TheRorange/-Comau_Smart5_NJ165/README.md

# Comau_Smart5_NJ165
This repository contains almost all files for analysis, simulation, design, programming, 3D printing, and assemblage of the Comau Smart5 NJ165 robot with a scale of 1:15 of the main size.
