TheRorange/-Comau_Smart5_NJ165/Report Eng.pdf

### Simulation and control of three degrees of freedom robot based on Comau smart5 NJ165

Sina Hasani Sadi

Department of electrical
engineering

sina_hs@aut.ac.ir

Romina Alishah

Department of electrical
engineering

elromina79@gmail.com

Shakila Kazempour
Dizaji

Department of electrical
engineering

shakila_kp@aut.ac.ir

Mahsa Beglari

Department of electrical
engineering

mahsabeglari@aut.ac.ir

Parisa Fakhre Tabatabaie

Department of electrical
engineering

Par_fr@aut.ac.ir

Mohamad Mahdi Malverdi

Department of electrical
engineering

mahdi.ma78@aut.ac.ir

Mahdi Keshtani Mehrzad

Department of electrical
engineering

m.mehrzad@aut.ac.ir

Abstract__ In this article, a three-degree-of-freedom robot is designed by SOLIDWORKS, then we
attempted to implement the robot practically, and finally, controlled the robot using Arduino and MATLAB.

INTRODUCTION

Nowadays, industrial robots play an important role in performing complex operations at high speeds. This category of robots must have the ability to perform precise and sensitive operations continuously and repeatedly. However, robot

manufacturers | make | controllers
available to users so that they can
improve | their | capabilities | and
computing power. On the other hand, the scientific community requires conducting numerous researches and improvements on systems in a short period of time. In this project, work will be done on the Comau Smart5 NJ165 robot.

To simplify the project in our practical work, we modeled a three-degree-of-freedom robot based on the first three degrees of freedom of Comau Smart5 NJ165 on a smaller scale.

Considering that the last three joints of their axes pass through the same point, it does not affect the movement of the end effector and only determines its orientation.

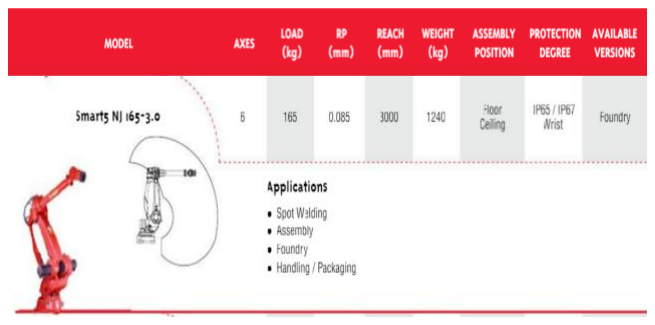
[picture p1: figure]
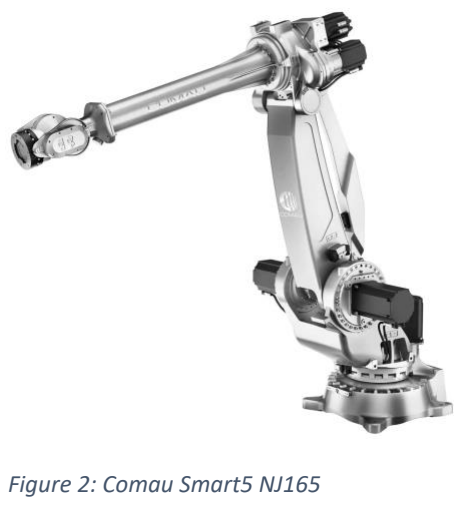
[picture p2: figure]
Figure 2: Comau Smart5 NJ165

Ⅰ. Robot design

The first step to implement the robot is to design it in software such as SOLIDWORKS, then links of the robot can be printed with help of 3D printing technology.

The main issue here was to keep the weight of the robot as low as possible but at the same time, it had to be large enough for motors to be placed on it. By using knowledge of the mechanics of materials we tried to lower the weight by omitting extra parts of the robot and making links hollow. Also, added some beams to the weak points to increase the strength of those points against loads and stresses acting on them.

Figure 1: Comau Smart5 basic info

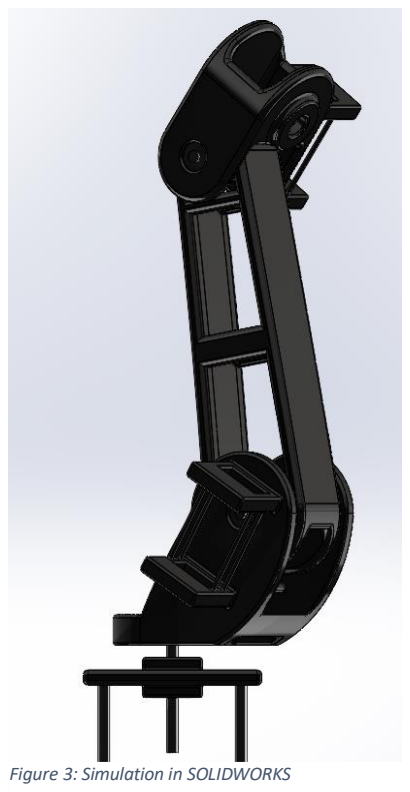
[picture p3: figure]
Figure 3: Simulation in SOLIDWORKS

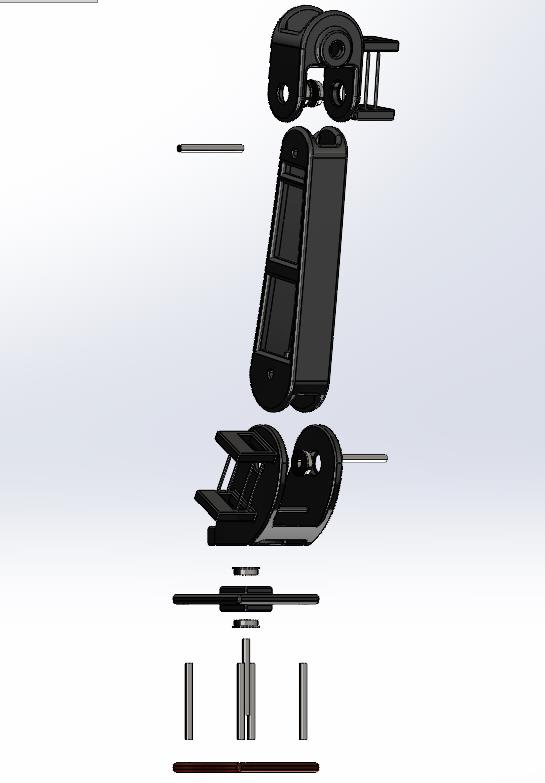
[picture p4: figure]
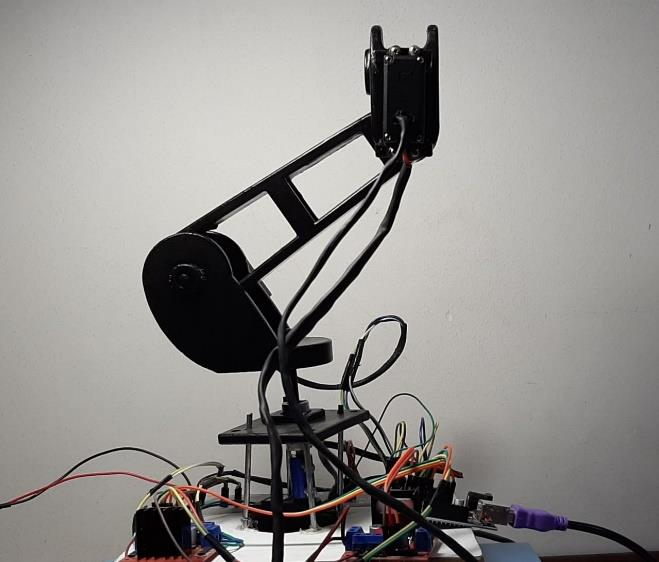
[picture p5: figure]

Figure 5: Assembled robot

Ⅱ. Forward Kinematics

To control the arm, we needed forward and inverse kinematics of the robot. Results are shown below:

T0

3
= [

σ1
σ2cos(θ3

) − σ3sin (θ3)

σ3 sin(θ3

) − σ2 cos(θ3

)
σ1

0 −0.146875(sin(θ2

) cos(θ1

) + sin(θ1

) cos(θ2

)) − 0.03125(σ3 cos(θ3

) + σ2 sin(θ3

))
0 −0.146875(cos(θ2

) cos(θ1

) + sin(θ1

) sin(θ2

)) − 0.03125(σ2 cos(θ3

) + σ3 sin(θ3

))
0 | 0 | 1 | 0.015
0 | 0 | 0 | 1

]

σ1 = −σ3sin(θ3

) − σ2 cos(θ3

)

σ2 = cos(θ1

) cos(θ2

) − sin(θ1

) sin(θ2

)

σ3 = cos(θ1

) sin(θ2

) − sin(θ1

) cos(θ2

)

End Effector Position:

P =
[

−0.146875(sin(θ2

) cos(θ1

) + sin(θ1

) cos(θ2

)) − 0.03125(σ3 cos(θ3

) + σ2 sin(θ3

))
−0.146875(cos(θ2

) cos(θ1

) + sin(θ1

) sin(θ2

)) − 0.03125(σ2 cos(θ3

) + σ3 sin(θ3

))
0.015

]

Transform matrix is obtained based on Classical Denavit Hartenberg method.

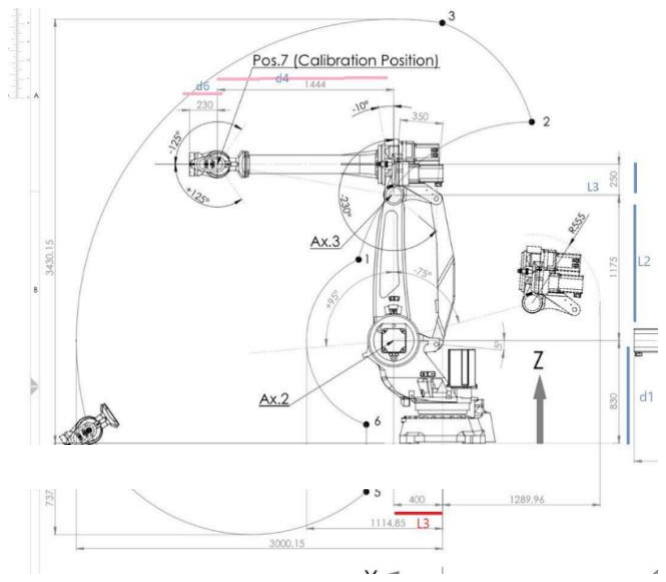
[picture p6: figure]

Ⅲ. Inverse Kinematics

Pee = [

x
y
z

]

θ1 = atan2(x, y)

Figure 4: Robot links

Figure 6

θ3 = cos⁻¹ (
x

2 + y

2 + (z − 0.015)

2 − 0.0225488281
0.0091796875 | )

θ2 =
tan⁻¹

(
0.0045898438sin(θ3

)+0.0004882813 sin(2θ3

)±(z−0.015)√x
2+y²

x

2+y²+0.0215722656+0.0009765625cos²(θ3 )+0.0091796875cos (θ3)

)

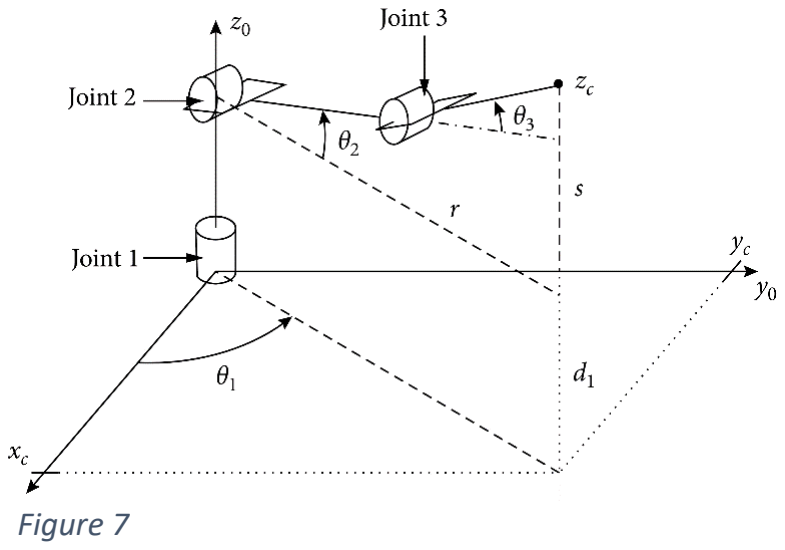
[picture p7: figure]
Figure 7

Ⅳ. Mass and Inertia Matrix

The mass of each link and its matrix of inertia around its center of mass is also calculated for further use:

Mass (kg):

Link 1: m1 = 0.0375

Link 2: m2 = 0.10235

Link 3: m3 = 0.0548

Moment of Inertia (kg.m²
):

Link 1: I1 =
[
0.0009 | −0.00003 | 0.00001
−0.00003 | 0.0001 | −0.00001
0.00001 | −0.00001 | 0.00009

]

Link 2: I2 =
[
0.0004 | 0 | 0
0 | 0.00033 | 0
0 | 0 | 0.00034

]

Link 3: I3 =
[
0.00004 | 0 | 0
0 | 0.00003 | 0
0 | 0 | 0.00005

]

Ⅴ. Robot programming with inverse kinematics

The next step was to control the arm. For this manner, we have used three servo motors. We removed the controller board of each motor and connected themotorsto L298N motor drivers to provide enough voltage for running the motors. We connected the drivers to a 12-volt dc source and pins of Arduino Uno board. To program the board, we used the Simulink environment of MATLAB and the Simulink support package for arduino hardware. The block diagram designed is shown below:

The idea behind the Simulink model we made is that the desired point that the end effector wants to reach is given to the model in the Cartesian space. But we can only control the angles of the motors. So, we used the equations which were derived at the inverse kinematic part to obtain the desired angle of each link from desired end effector position. This is what the inverse kinematics block does. It actually gets the ee position and gives the desired angles as its output.

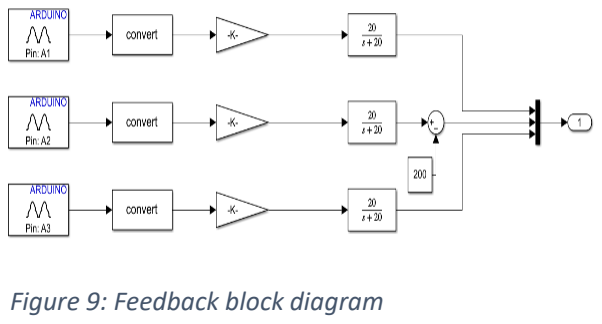
[picture p8: figure]
Figure 9: Feedback block diagram

These angles go to the controller block as input signals to be compared with the feedback signals received from the potentiometers to get the error and generate the necessary output signal to be sent to the PWM block by PID control.

In the feedback block, the data coming from the potentiometer is processed and sent to the controller as feedback.

Also, calibration of angles of motors relative to joint angles is done in this block by summing constants with the feedback signals.

In the PWM block, using the output signals of the controller, the required direction and rotation speed of each motor are calculated and applied to the motor to reach the desired point.

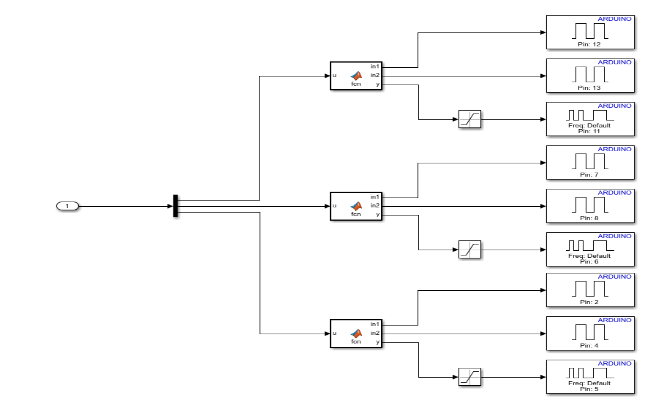
[picture p9: figure]

Figure 8: PWM block diagram

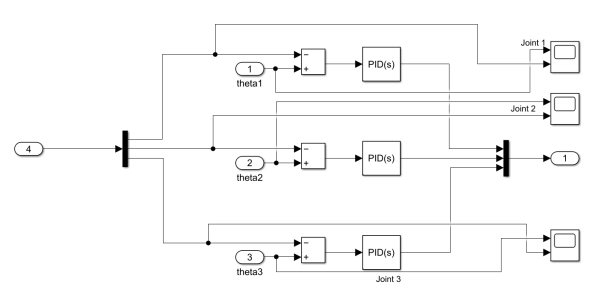
[picture p10: figure]

Figure 10: Controller block diagram

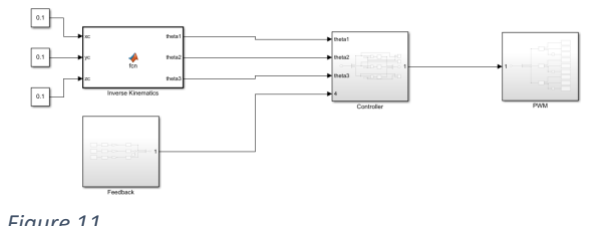
[picture p11: figure]

Figure 11

Ⅵ. Conclusion

There were many challenges in the way of implementing the robot for example, the Arduino board did not apply the necessary voltage to start the motors ,this problem was solved by a motor driver and a 12 volt power supply .

Another problem was related to costs, the dimensions of robot should be appropriate to reduce the weight of the robot .

The diameter of the shaft in engine is considered 5 mm , therefore , one side of the couplings should be 5 mm and the other side should be 6 mm and this type of coupling is rare , we drilled 5mm couplings until one side becomes 6mm.

### REFERENCES

[1] John J. Craig, Introduction to Robotics Mechanics and Control, Third Edition
[2] Mark W. Spong, Robot Modeling and Control
