TheRorange/-Comau_Smart5_NJ165/solidworks files/Assem1.SLDASM

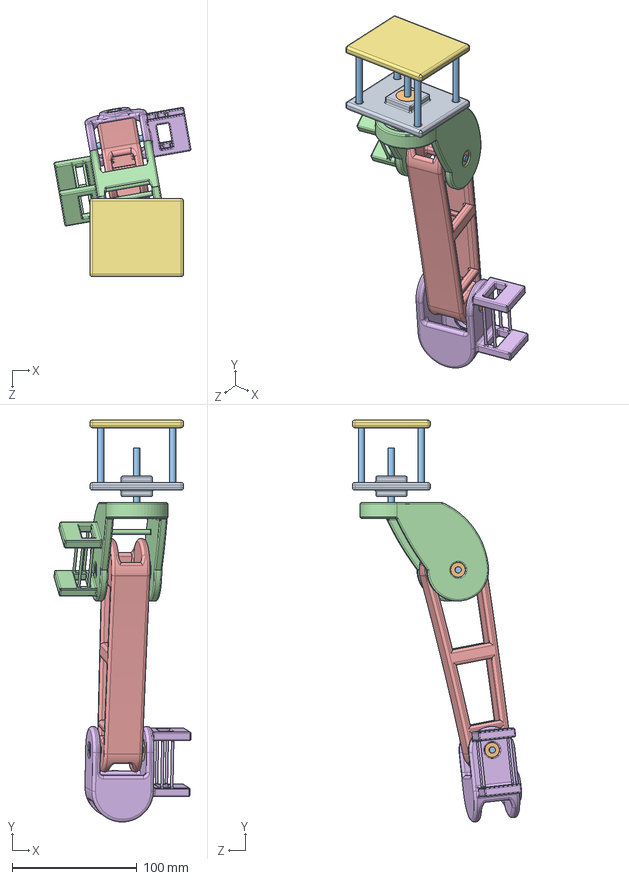
[picture p12: CAD file, 2022-10-16]
solidworks files/Assem1.SLDASM
109.7 x 321.9 x 135.6 mm
