TheRorange/-Comau_Smart5_NJ165/solidworks files/Part3.SLDPRT

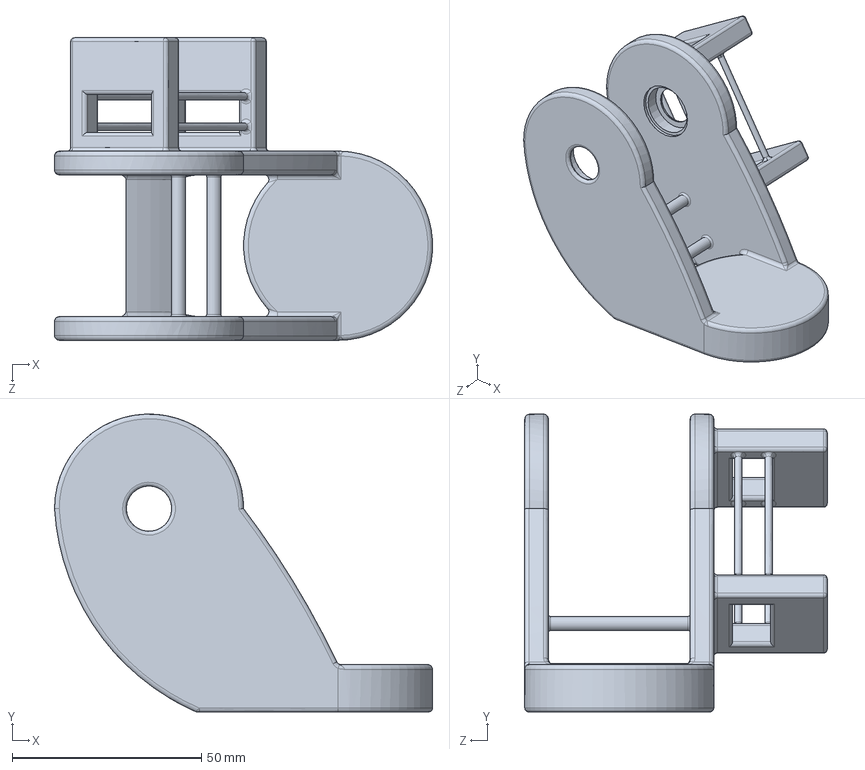
[picture p13: CAD file, 2022-10-16]
solidworks files/Part3.SLDPRT
100.0 x 78.7 x 80.0 mm
