TheRorange/-Comau_Smart5_NJ165/solidworks files/Part2.SLDPRT

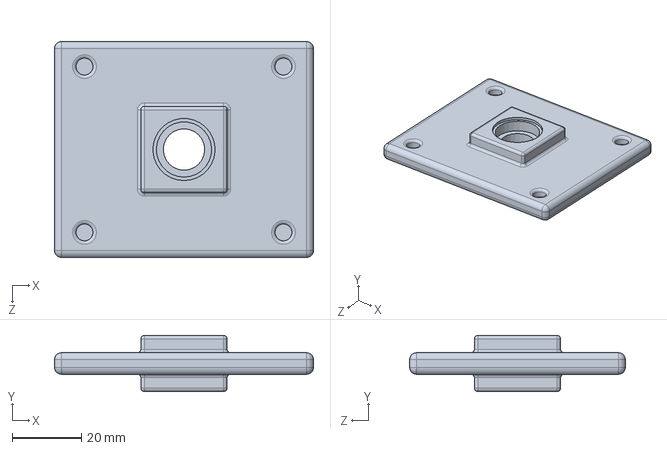
[picture p14: CAD file, 2022-10-16]
solidworks files/Part2.SLDPRT
75.0 x 16.2 x 62.5 mm
