TheRorange/-Comau_Smart5_NJ165/solidworks files/Part4.SLDPRT

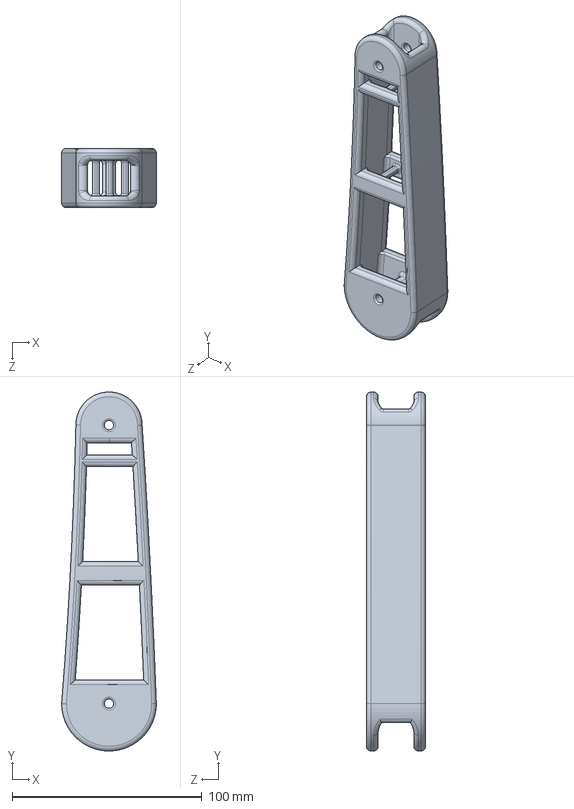
[picture p15: CAD file, 2022-10-16]
solidworks files/Part4.SLDPRT
50.0 x 189.4 x 31.2 mm
