TheRorange/-Comau_Smart5_NJ165/solidworks files/Part7.SLDPRT

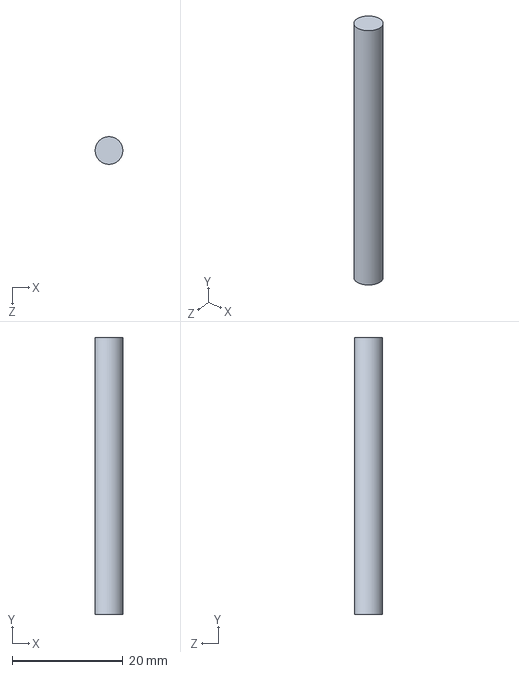
[picture p16: CAD file, 2022-10-16]
solidworks files/Part7.SLDPRT
5.00 x 50.0 x 5.00 mm
