TheRorange/-Comau_Smart5_NJ165/solidworks files/Part6.SLDPRT

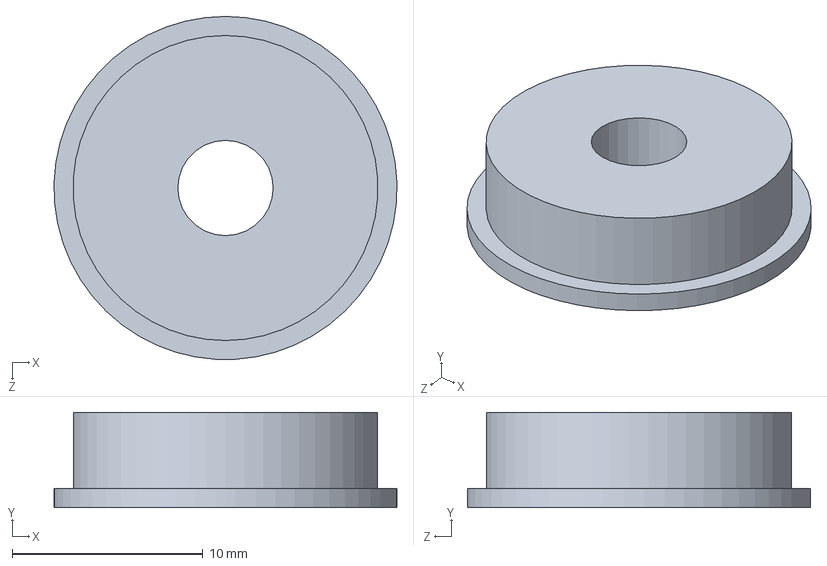
[picture p17: CAD file, 2022-10-16]
solidworks files/Part6.SLDPRT
18.0 x 5.00 x 18.0 mm
