TheRorange/-Comau_Smart5_NJ165/solidworks files/Part5.SLDPRT

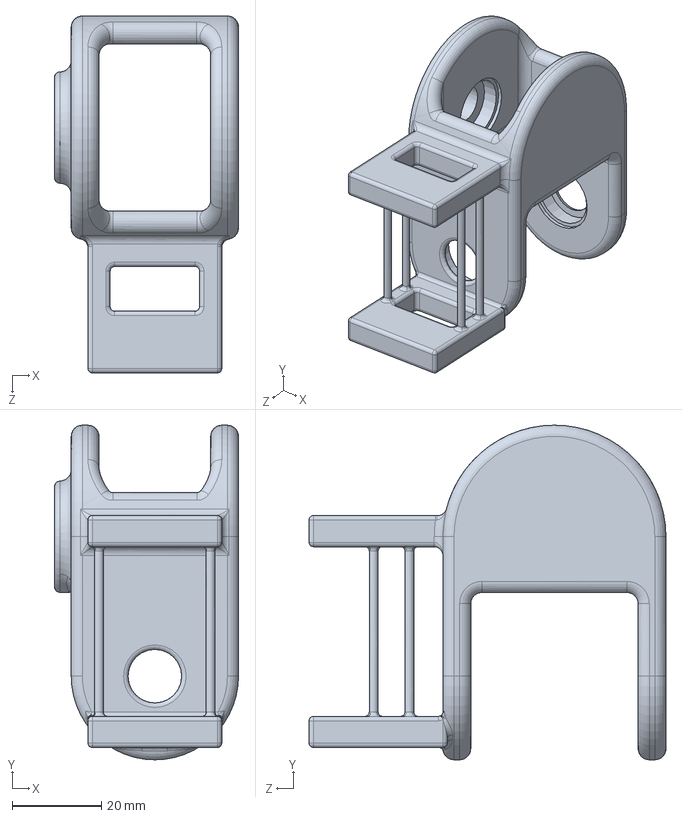
[picture p18: CAD file, 2022-10-16]
solidworks files/Part5.SLDPRT
41.2 x 75.0 x 80.0 mm
