TheRorange/-Comau_Smart5_NJ165/solidworks files/Part1.SLDPRT

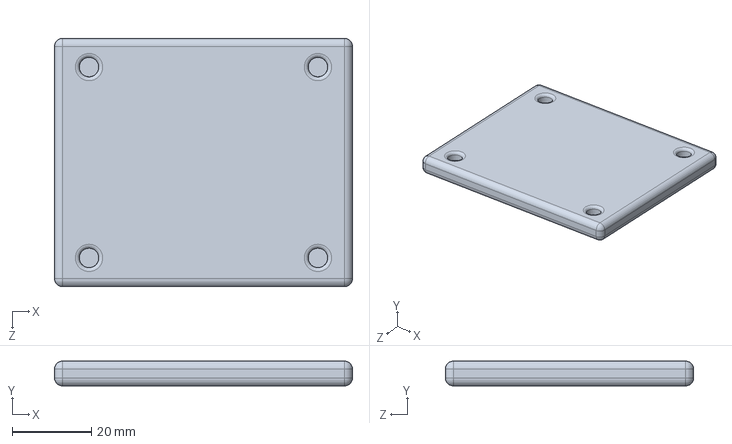
[picture p19: CAD file, 2022-10-16]
solidworks files/Part1.SLDPRT
75.0 x 6.25 x 62.5 mm
